NataliaMunive/SensorTemperatura/img/diagrama_bloques.png

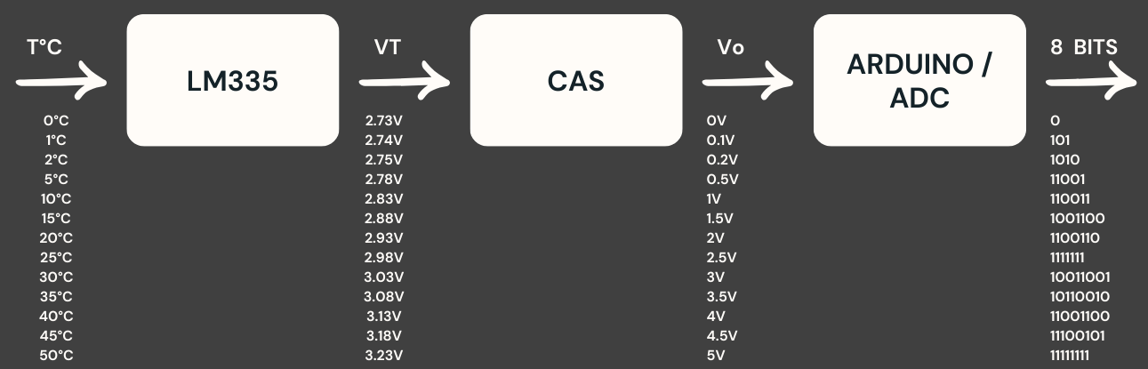
img/diagrama_bloques.png
