NataliaMunive/SensorTemperatura/img/formulas.png

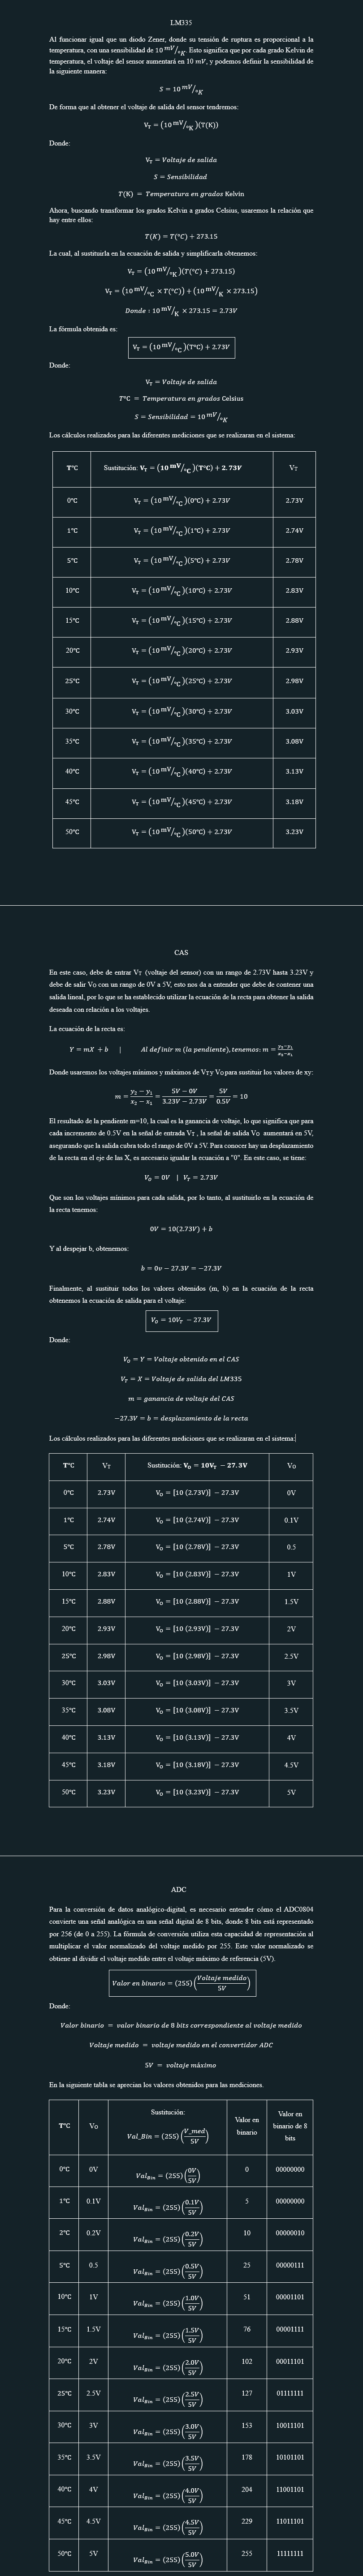
img/formulas.png
