NataliaMunive/SensorTemperatura/img/nube1.png

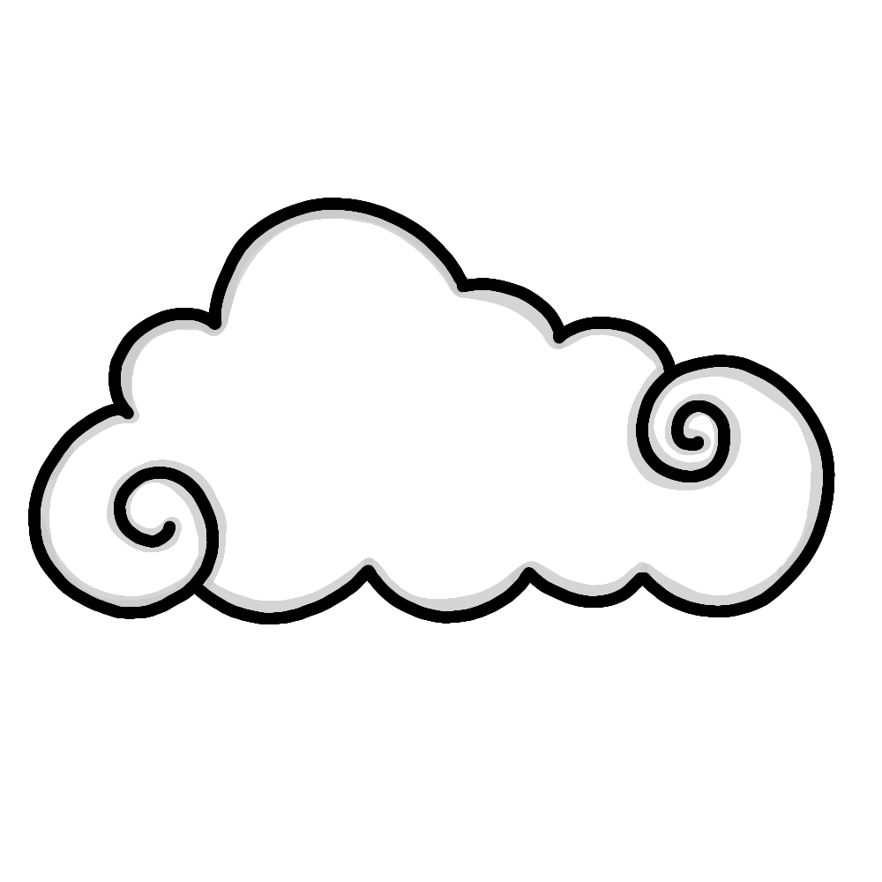
img/nube1.png
