NataliaMunive/SensorTemperatura/img/nube2.png

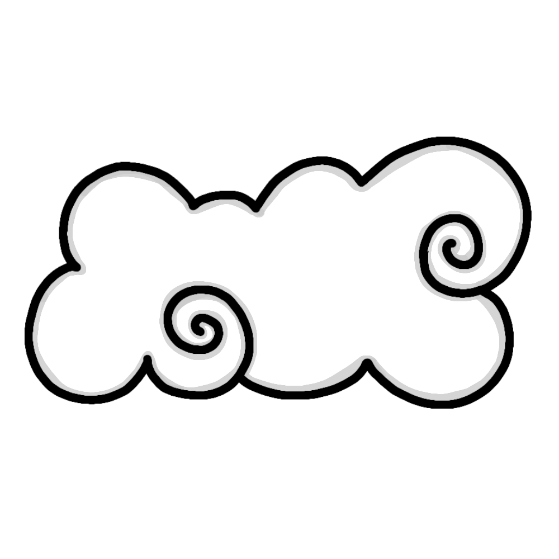
img/nube2.png
