NataliaMunive/SensorTemperatura/img/nube3.png

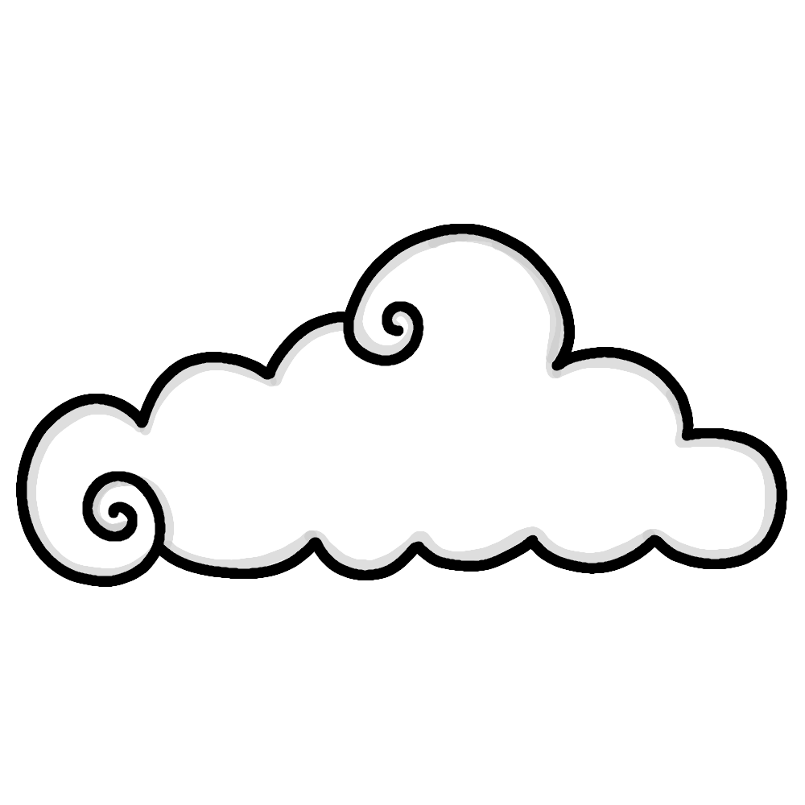
img/nube3.png
