NataliaMunive/SensorTemperatura/img/PNG.png

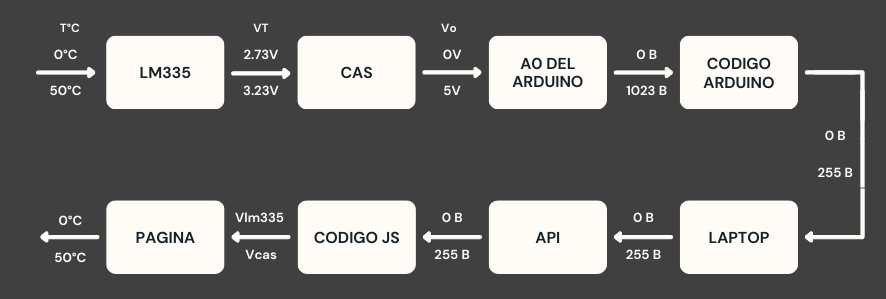
img/PNG.png
