NataliaMunive/SensorTemperatura/img/Sol.gif

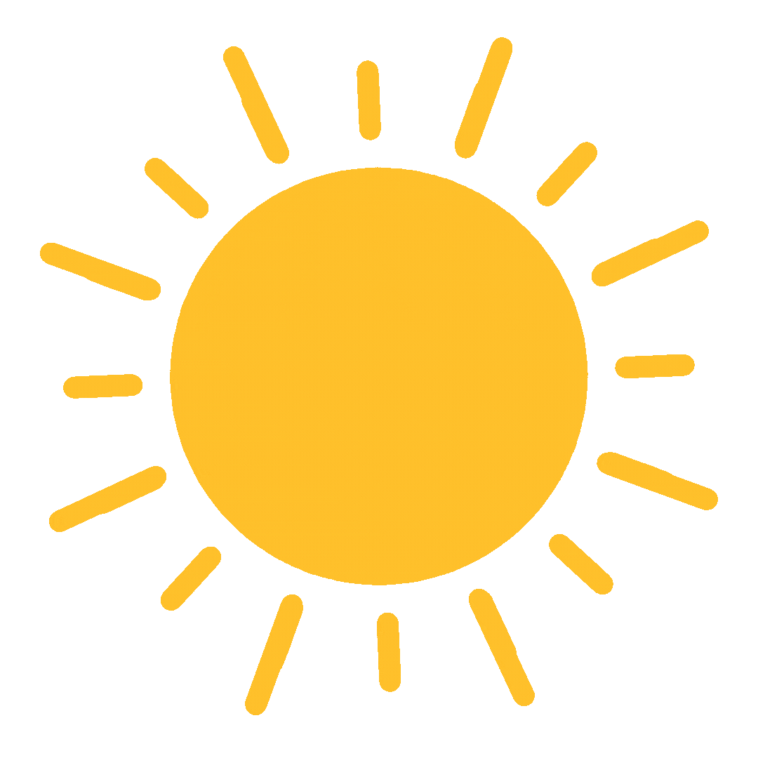
img/Sol.gif
